SpaceTeam/STS1_PCB_LIBRARIES/3d/STS_Inductor_SMD/vishay_ihlp4040.step

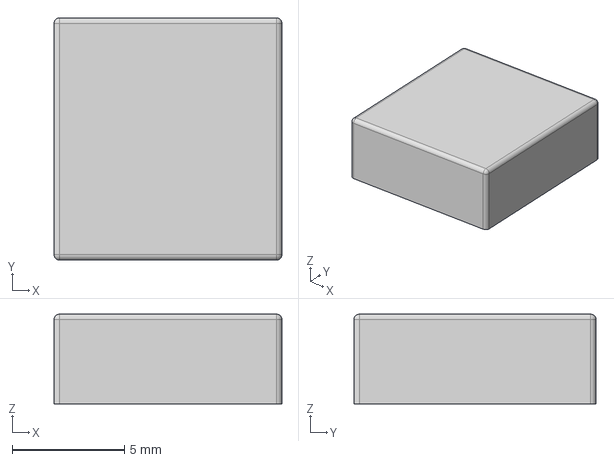
[picture p1: CAD file, 2024-08-04]
3d/STS_Inductor_SMD/vishay_ihlp4040.step
10.2 x 10.8 x 4.00 mm
