SpaceTeam/STS1_PCB_LIBRARIES/3d/STS_Misc/CD4002BNSR.step

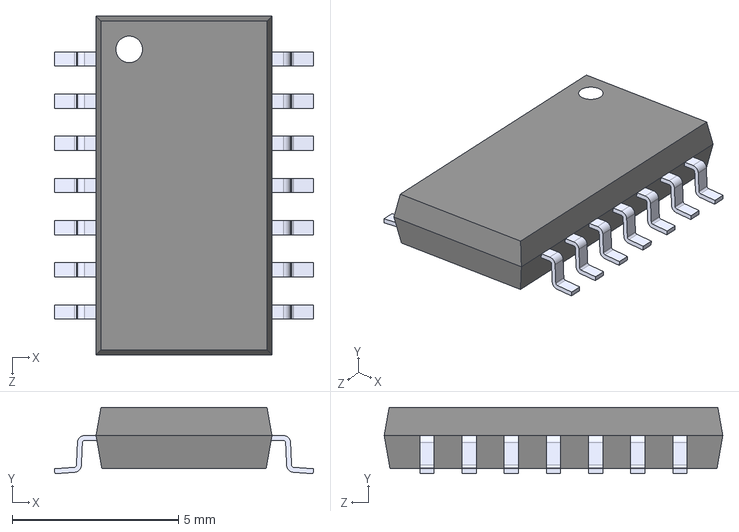
[picture p2: CAD file, 2024-08-04]
3d/STS_Misc/CD4002BNSR.step
7.80 x 2.00 x 10.2 mm
