SpaceTeam/STS1_PCB_LIBRARIES/3d/STS_Package_DFN_QFN/Maxim_22Pin_FC2QFN.step

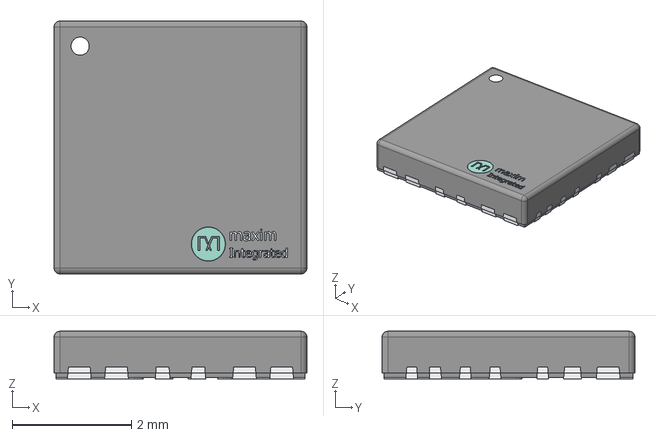
[picture p3: CAD file, 2022-03-08]
3d/STS_Package_DFN_QFN/Maxim_22Pin_FC2QFN.step
4.25 x 4.25 x 0.801 mm
