SpaceTeam/STS1_PCB_LIBRARIES/3d/STS_Package_QSOP/MAX_QSOP24.step

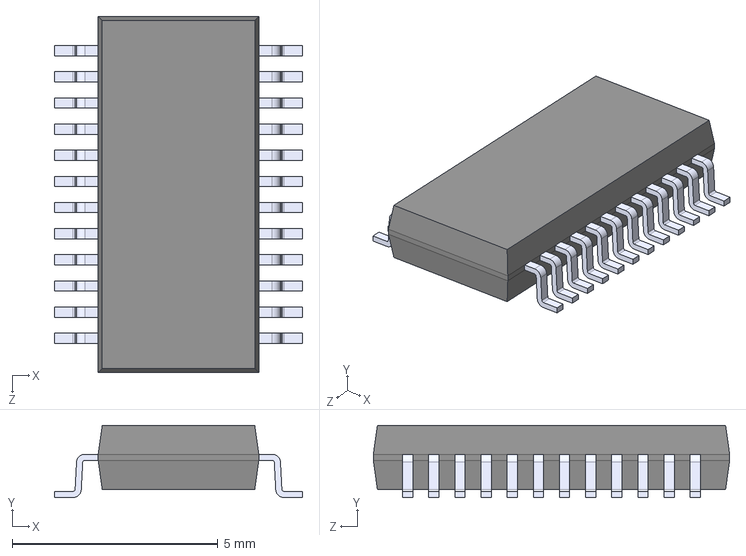
[picture p4: CAD file, 2024-08-04]
3d/STS_Package_QSOP/MAX_QSOP24.step
6.02 x 1.75 x 8.65 mm
