SpaceTeam/STS1_PCB_LIBRARIES/3d/STS_Package_SO/POWERPAK_SO8.STEP

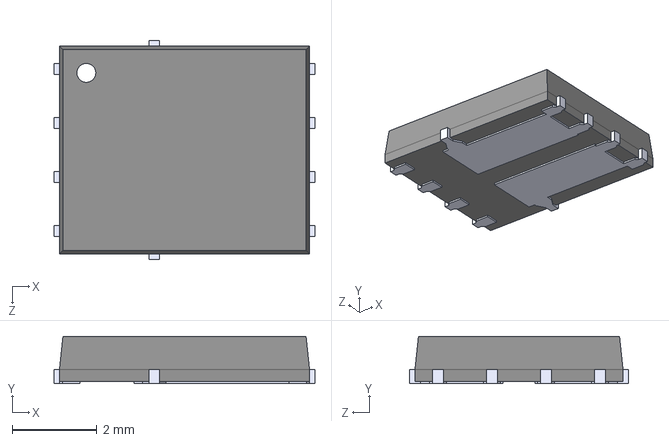
[picture p5: CAD file, 2024-08-04]
3d/STS_Package_SO/POWERPAK_SO8.STEP
6.15 x 1.12 x 5.16 mm
