SpaceTeam/STS1_PCB_LIBRARIES/3d/STS_Package_VSON/TI_VSON8.step

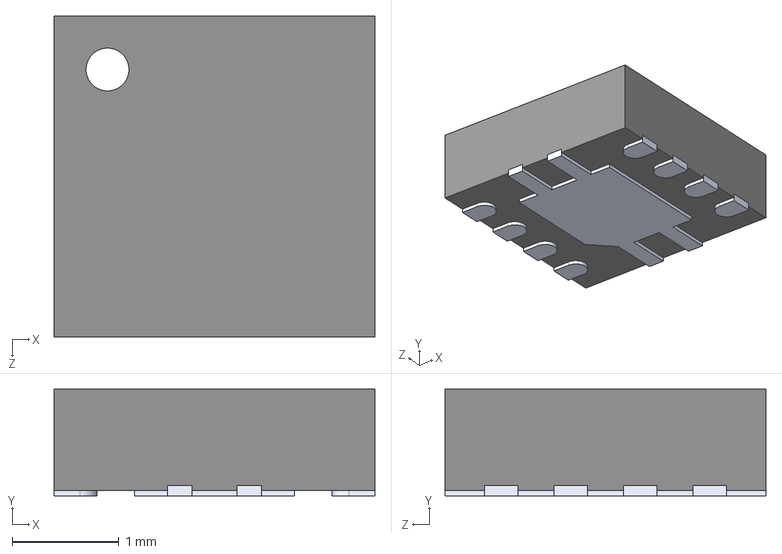
[picture p6: CAD file, 2024-08-04]
3d/STS_Package_VSON/TI_VSON8.step
3.00 x 1.00 x 3.00 mm
