SpaceTeam/STS1_PCB_LIBRARIES/3d/STS_RF/Mini-Circuits-SM1L.stp

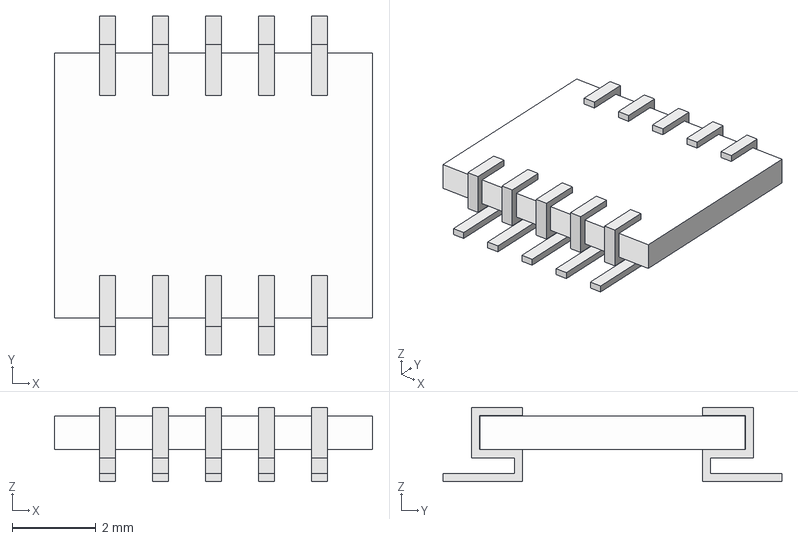
[picture p7: CAD file, 2026-11-08]
3d/STS_RF/Mini-Circuits-SM1L.stp
7.62 x 8.12 x 1.78 mm
Body_Extrude
Pin_Clone9
Pin_Clone5
Pin_Clone6
Pin_Clone7
Pin_Clone8
Pin_Extrude
Pin_Clone1
Pin_Clone2
Pin_Clone3
Pin_Clone4
