SpaceTeam/STS1_PCB_LIBRARIES/3d/TE_Connector_SMB/c-consmb001-g-a-3d.stp

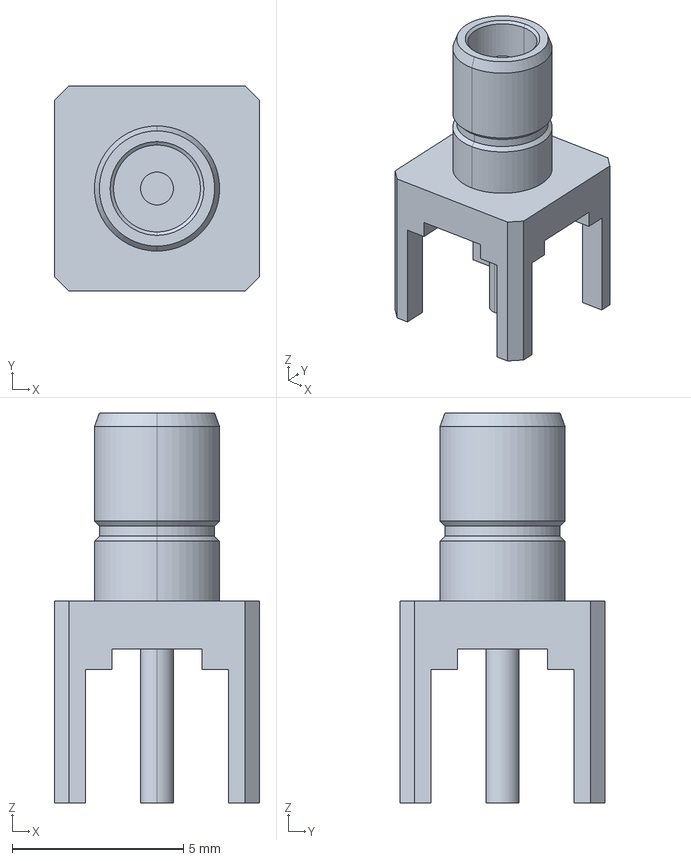
[picture p8: CAD file, 2026-11-08]
3d/TE_Connector_SMB/c-consmb001-g-a-3d.stp
6.00 x 6.00 x 11.4 mm
