SpaceTeam/STS1_PCB_LIBRARIES/3d/STS_Connector/ZF5S-08-01-T-WT.step

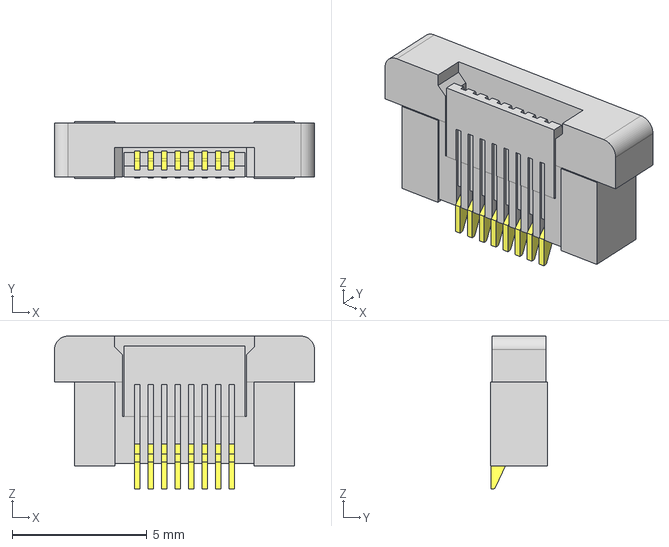
[picture p9: CAD file, 2026-11-08]
3d/STS_Connector/ZF5S-08-01-T-WT.step
9.65 x 2.10 x 5.67 mm
C-297-08-01_pins
ZF5S-08-01-WT_socket
