SpaceTeam/STS1_PCB_LIBRARIES/3d/STS_Inductor_SMD/WE-PD_1260.stp

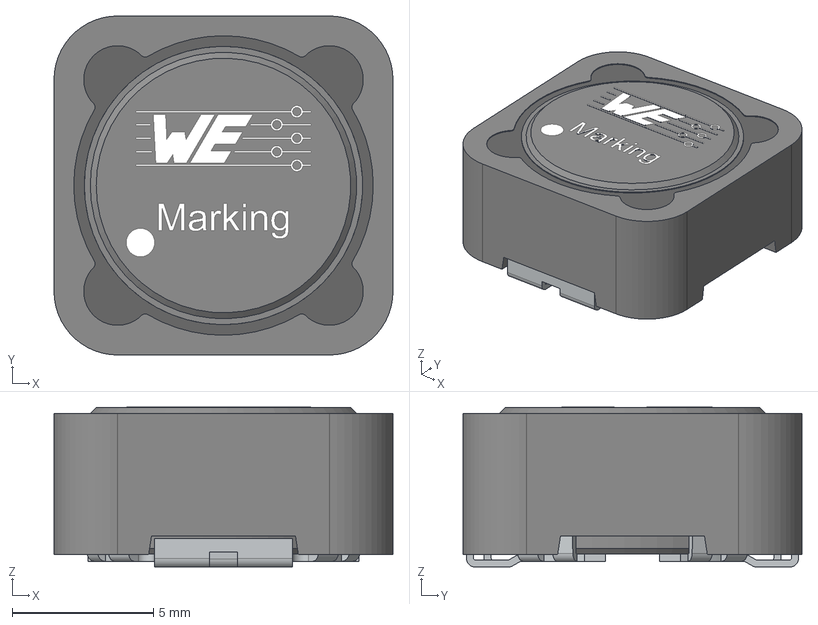
[picture p10: CAD file, 2023-01-22]
3d/STS_Inductor_SMD/WE-PD_1260.stp
12.0 x 12.0 x 5.66 mm
Core
ShieldRing
Glue
Leadframe
