SpaceTeam/STS1_PCB_LIBRARIES/3d/STS_Connector/T1M-08-F-SV-L.stp

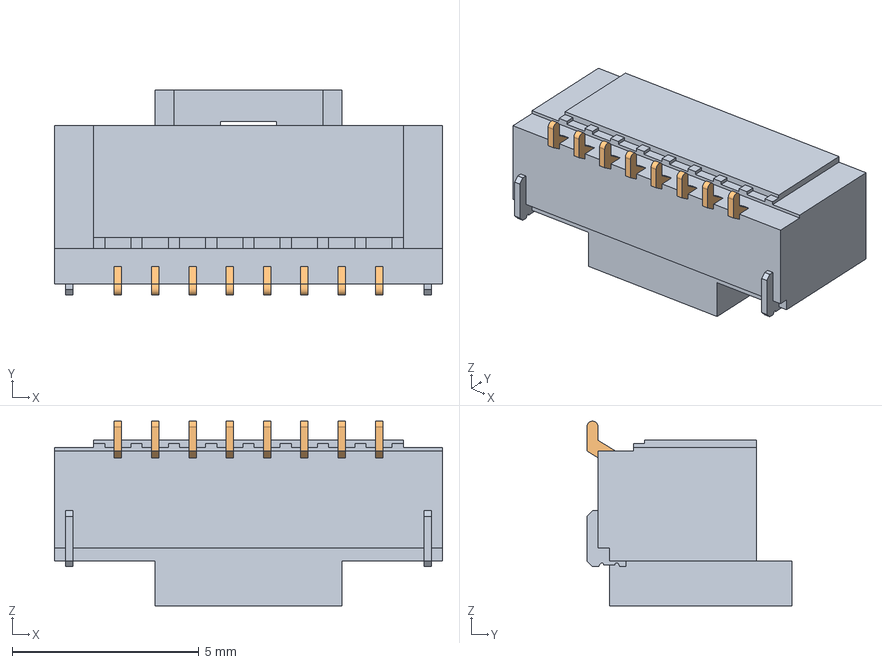
[picture p11: CAD file, 2026-11-08]
3d/STS_Connector/T1M-08-F-SV-L.stp
10.4 x 5.50 x 4.95 mm
T1T1M-08-T-SV-L
P2T1M-08-F-SV-L
P22T1M-08-F-SV-L
