SpaceTeam/STS1_PCB_LIBRARIES/3d/STS_Connector/STS1_EPS_DT_FIX_2.step

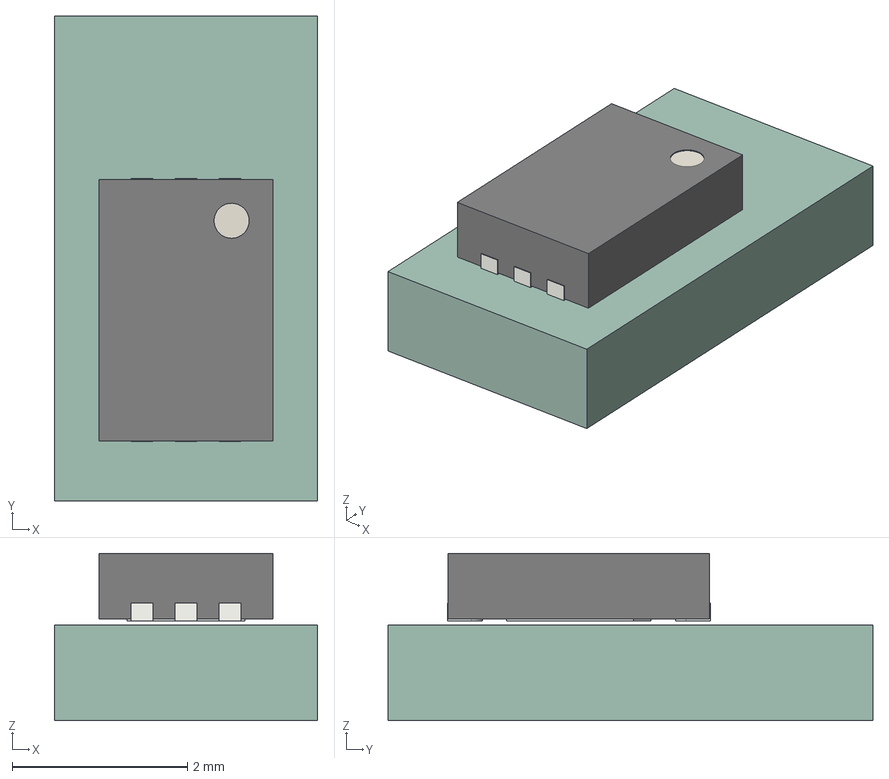
[picture p12: CAD file, 2026-11-08]
3d/STS_Connector/STS1_EPS_DT_FIX_2.step
3.00 x 5.53 x 1.91 mm
DFN_6_1EP_3x2mm_Pitch05mm
STS1_EPS_DT_FIX_2_PCB
