SpaceTeam/STS1_PCB_LIBRARIES/3d/STS_Connector/ZF5S-15-01-T-WT-K-TR.step

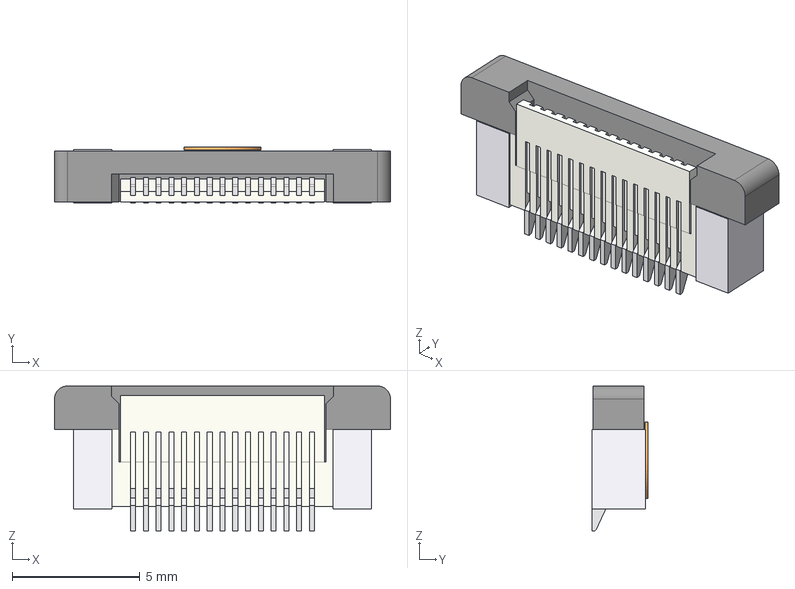
[picture p13: CAD file, 2025-03-16]
3d/STS_Connector/ZF5S-15-01-T-WT-K-TR.step
13.2 x 2.21 x 5.67 mm
ZF5S-15-01-WT_socket
C-297-15-01_pins
K-DOT-.118-.219-.005_polyamide_pick
