SpaceTeam/STS1_PCB_LIBRARIES/3d/STS_Connector/ESQT-125-02-M-D-560.stp

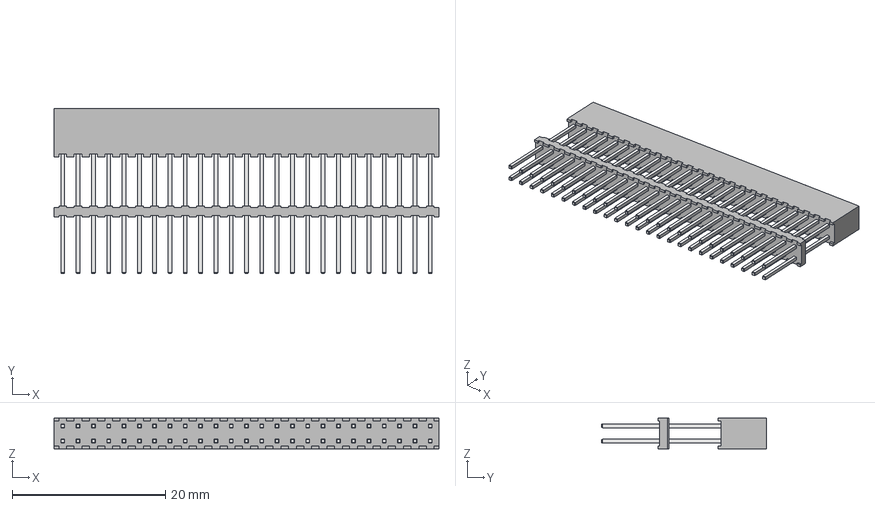
[picture p14: CAD file, 2024-08-04]
3d/STS_Connector/ESQT-125-02-M-D-560.stp
50.3 x 21.6 x 4.00 mm
ESQT-125-02-M-D-560_BS
ESQT-125-02-M-D-5602_P
ESQT-125-02-M-D-560_P
ESQT-125-02-M-D-560_S
