SpaceTeam/STS1_PCB_LIBRARIES/3d/STS_Connector/SQW-125-01-L-D-VS.stp

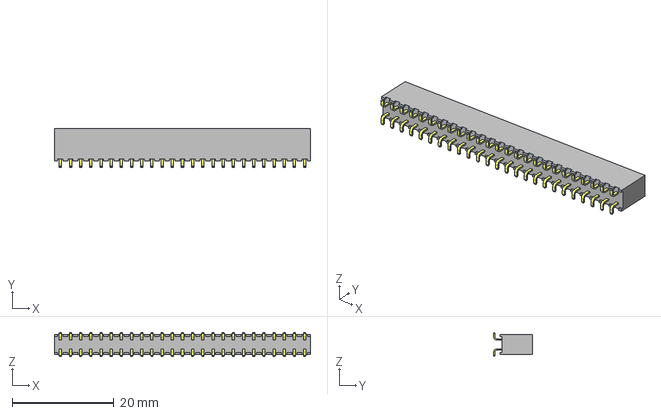
[picture p15: CAD file, 2024-08-04]
3d/STS_Connector/SQW-125-01-L-D-VS.stp
50.3 x 7.62 x 4.75 mm
P1SQW-125-01-L-D-VS
S1SQW-125-01-L-D-VS
