SpaceTeam/STS1_PCB_LIBRARIES/3d/STS_Connector/ETMM-125-02-F-D-SM-TR.stp

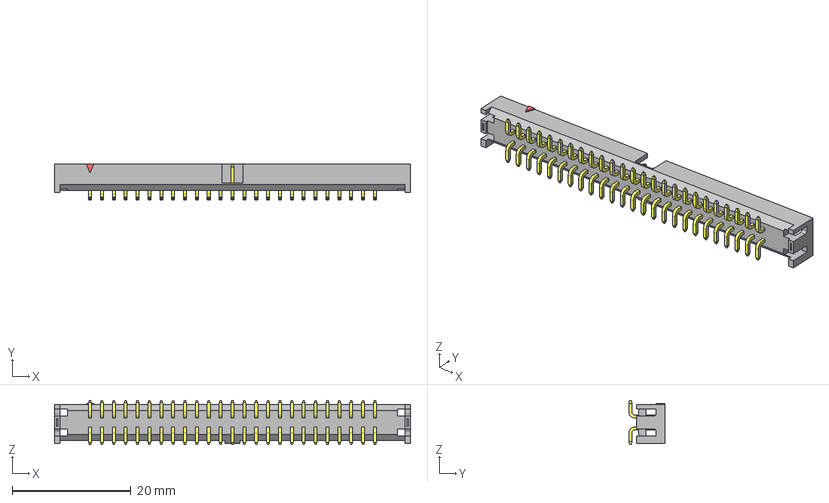
[picture p16: CAD file, 2024-08-04]
3d/STS_Connector/ETMM-125-02-F-D-SM-TR.stp
59.9 x 6.10 x 7.49 mm
ETMM-125-02-F-D-SM-TR_f
ETMM-125-02-F-D-SM-TR_k
ETMM-125-02-F-D-SM-TR_p
ETMM-125-02-F-D-SM-TR_t
