SpaceTeam/STS1_PCB_LIBRARIES/3d/STS_Connector/SSM-125-L-DV.stp

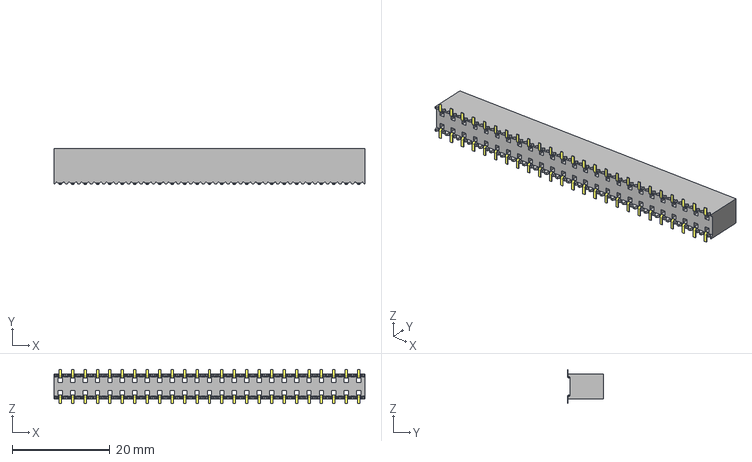
[picture p17: CAD file, 2024-08-04]
3d/STS_Connector/SSM-125-L-DV.stp
63.5 x 7.42 x 7.04 mm
C-137-0125
SSM-125-L-DV_body
