SpaceTeam/STS1_PCB_LIBRARIES/3d/STS_Connector/ESQT-111-02-F-D-640.stp

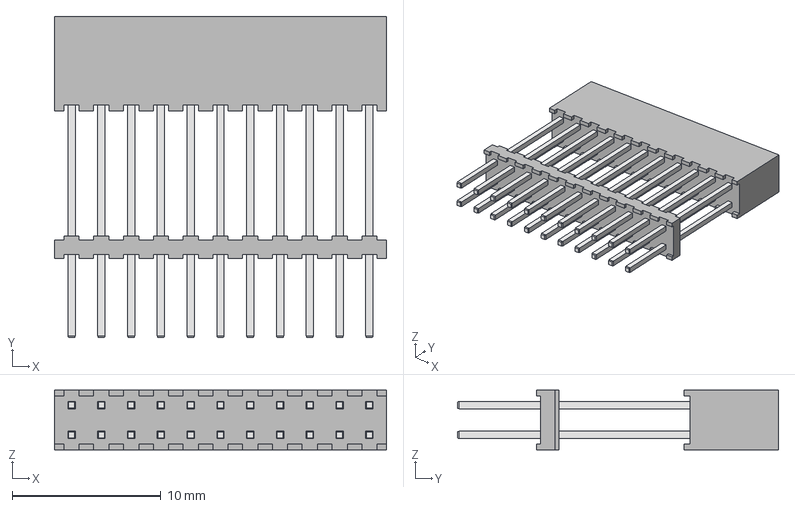
[picture p18: CAD file, 2024-08-04]
3d/STS_Connector/ESQT-111-02-F-D-640.stp
22.3 x 21.6 x 4.00 mm
ESQT-111-02-F-D-640_BS
ESQT-111-02-F-D-6402_P
ESQT-111-02-F-D-640_P
ESQT-111-02-F-D-640_S
