SpaceTeam/STS1_PCB_LIBRARIES/3d/STS_Connector/TMM-125-01-T-D-SM.stp

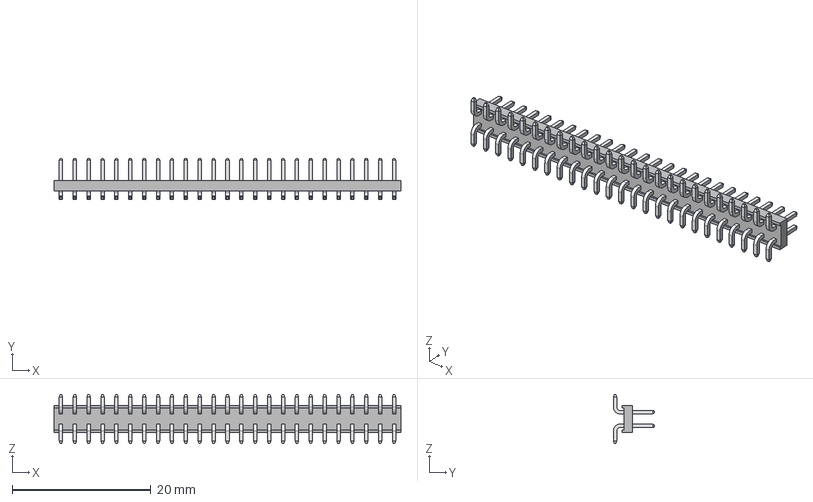
[picture p19: CAD file, 2024-08-04]
3d/STS_Connector/TMM-125-01-T-D-SM.stp
50.0 x 5.97 x 7.06 mm
TMM-125-01-T-D-SM_sm_pins2
TMM-125-01-T-D-SM_pins1
TMM-125-01-T-D-SM_body
