SpaceTeam/STS1_PCB_LIBRARIES/3d/STS_Connector/EHT-125-01-S-D-SM-SR.stp

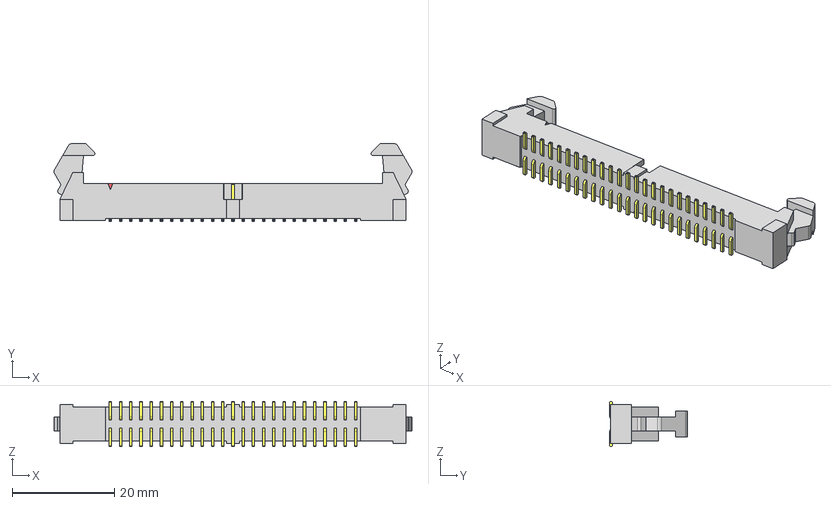
[picture p20: CAD file, 2024-08-04]
3d/STS_Connector/EHT-125-01-S-D-SM-SR.stp
70.0 x 15.2 x 8.89 mm
C-95-01-25-D-SM
EHT-First_Position_Indicator
EHT-125-01-D-SR_header
