SpaceTeam/STS1_PCB_LIBRARIES/3d/STS_Connector/ESQT-110-02-GF-D-800.stp

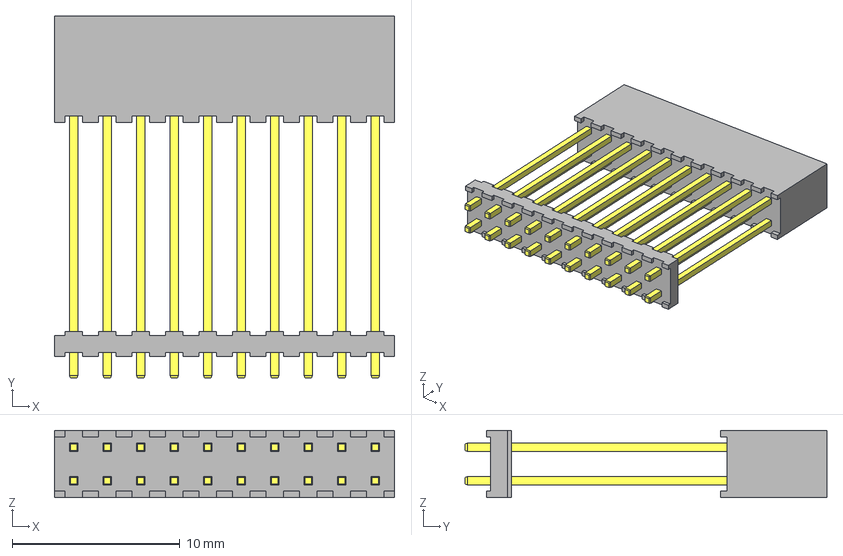
[picture p22: CAD file, 2024-08-04]
3d/STS_Connector/ESQT-110-02-GF-D-800.stp
20.3 x 21.6 x 4.00 mm
ESQT-110-02-GF-D-800_BS
ESQT-110-02-GF-D-800_P
ESQT-110-02-GF-D-800_S
