SpaceTeam/STS1_PCB_LIBRARIES/3d/STS_Connector/SQT-111-02-L-D.stp

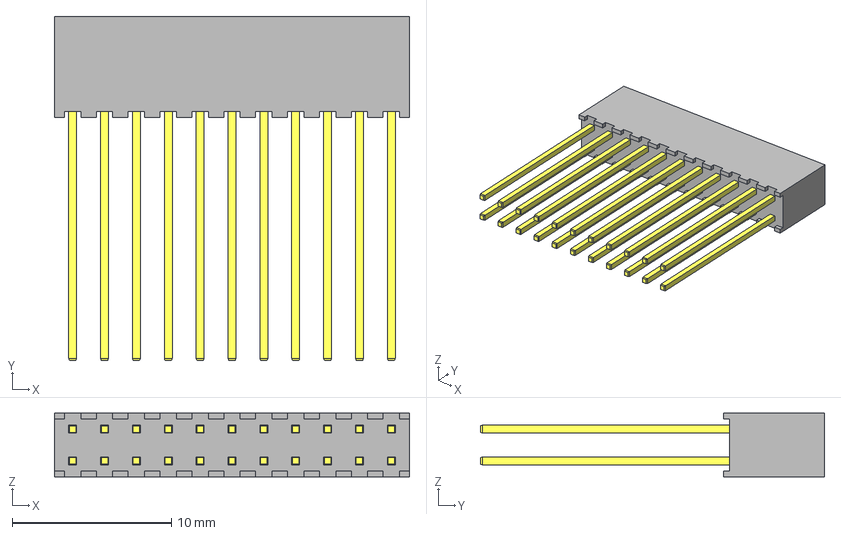
[picture p23: CAD file, 2024-08-04]
3d/STS_Connector/SQT-111-02-L-D.stp
22.3 x 21.6 x 4.00 mm
P1SQT-111-02-L-D
S1SQT-111-02-L-D
