SpaceTeam/STS1_PCB_LIBRARIES/3d/STS_Connector/ZF5S-08-03-T-WT.stp

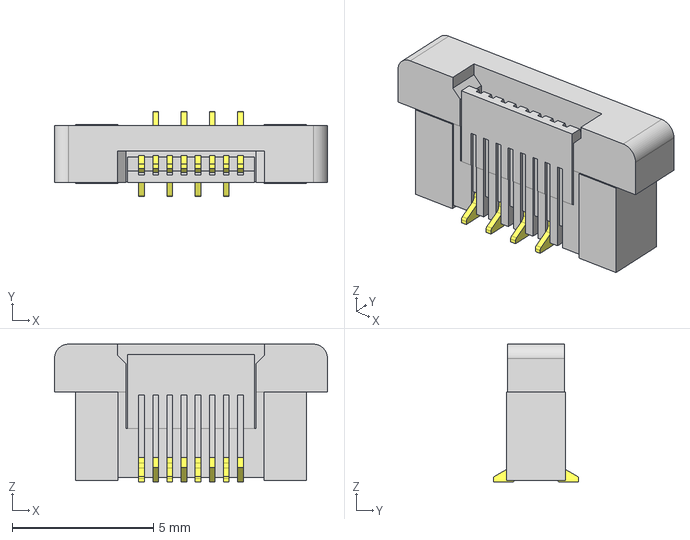
[picture p24: CAD file, 2024-08-04]
3d/STS_Connector/ZF5S-08-03-T-WT.stp
9.65 x 3.02 x 4.87 mm
C-297-08-03_pins
ZF5S-08-03-WT_socket
