SpaceTeam/STS1_PCB_LIBRARIES/3d/STS_Connector/ZF5S-10-01-T-WT.stp

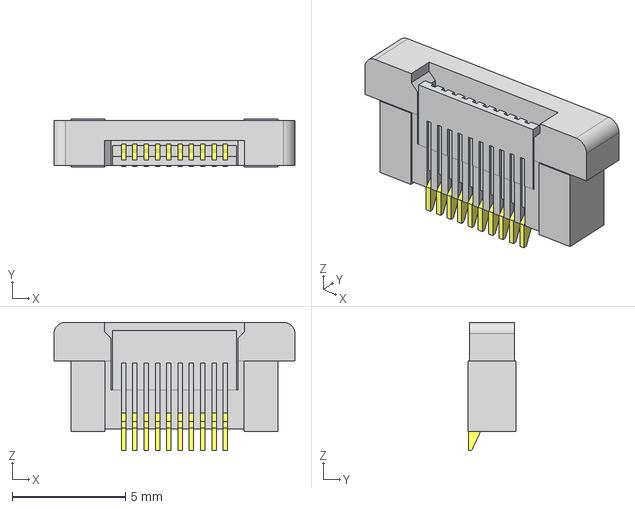
[picture p25: CAD file, 2024-08-04]
3d/STS_Connector/ZF5S-10-01-T-WT.stp
10.7 x 2.10 x 5.67 mm
C-297-10-01_pins
ZF5S-10-01-WT_socket
