SpaceTeam/STS1_PCB_LIBRARIES/3d/STS_Connector/ESQT-125-02-M-D-640.stp

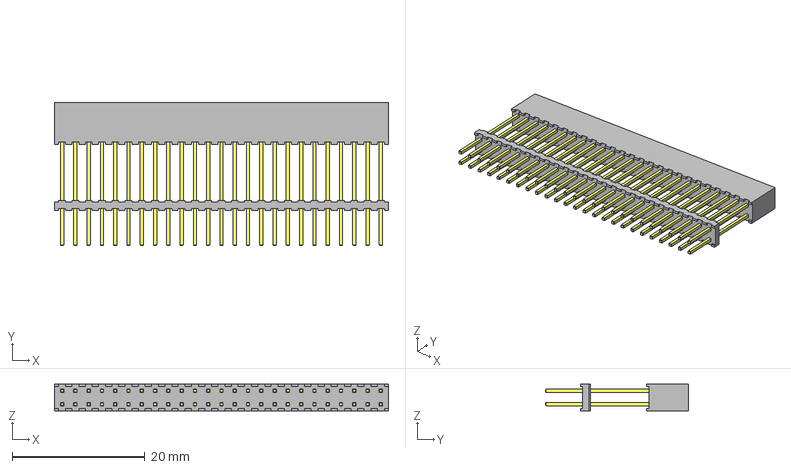
[picture p26: CAD file, 2024-08-04]
3d/STS_Connector/ESQT-125-02-M-D-640.stp
50.3 x 21.6 x 4.00 mm
ESQT-125-02-M-D-640_BS
ESQT-125-02-M-D-640_P
ESQT-125-02-M-D-640_S
