SpaceTeam/STS1_PCB_LIBRARIES/3d/STS_Connector/ZF5S-16-03-T-WT.step

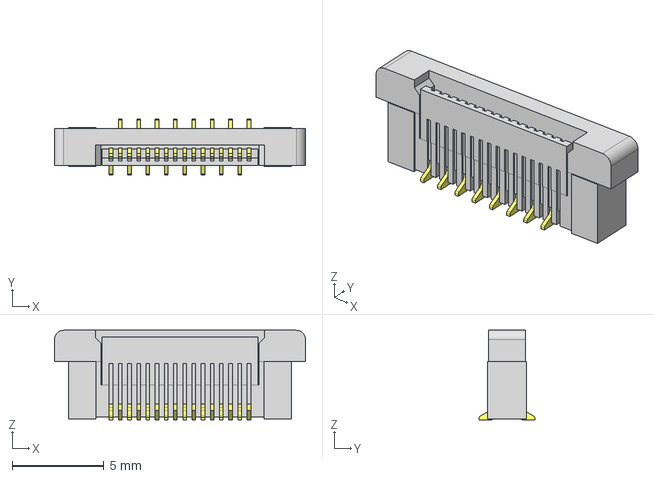
[picture p27: CAD file, 2024-08-04]
3d/STS_Connector/ZF5S-16-03-T-WT.step
13.7 x 3.02 x 4.87 mm
ZF5S-16-03-WT_socket
C-297-16-03_pins
