SpaceTeam/STS1_PCB_LIBRARIES/3d/STS_Connector/FTSH-105-01-X-DH-A.step

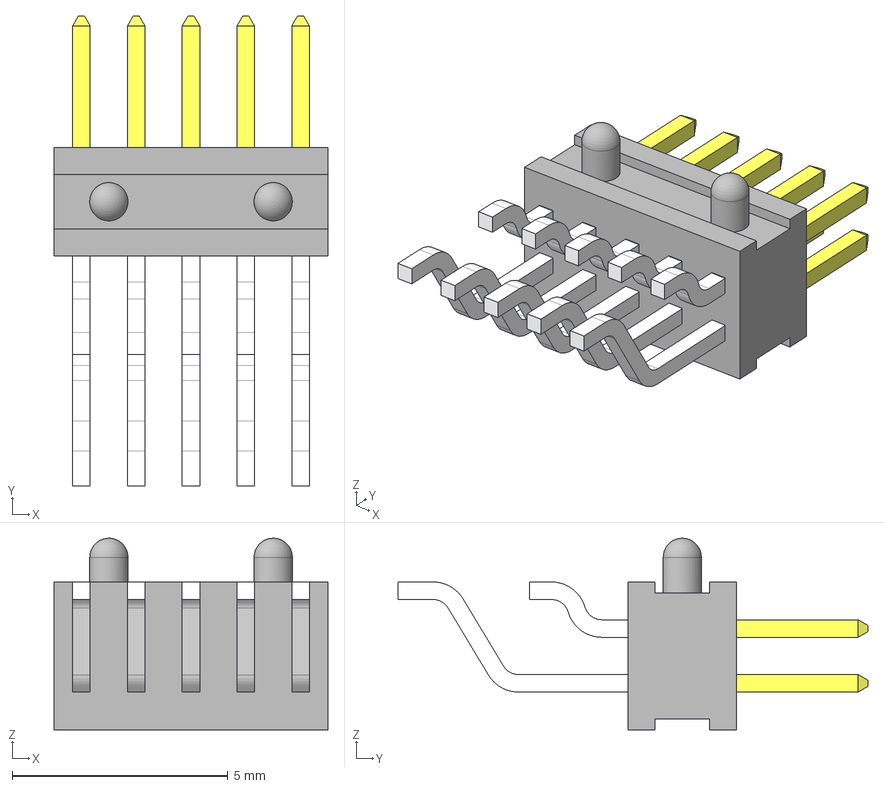
[picture p28: CAD file, 2023-01-22]
3d/STS_Connector/FTSH-105-01-X-DH-A.step
6.35 x 10.9 x 4.45 mm
FTSH-105-01-L-DH-TR_pins2
FTSH-105-01-L-DH-TR_pins1
FTSH-105-01-L-DH-A-TR_body
