SpaceTeam/STS1_PCB_LIBRARIES/(list of files, cad)

Other CAD files:
3d/STS_Package_SO/POWERPAK_SO8_single.STEP
3d/STS_Connector/ESQT-111-02-F-D-800.stp
3d/STS_Connector/ESQT-111-02-M-D-560.stp
3d/STS_Connector/1725672.stp
3d/STS_Connector/2078430004.stp
3d/STS_Connector/282834-4.step
3d/STS_Connector/282834-6.step
3d/STS_Connector/282834-7.step
3d/STS_Connector/436500415.stp
3d/STS_Connector/501461-0491.stp
3d/STS_Connector/M80-8280442P.stp
3d/STS_Connector/M80-8510845.stp
3d/STS_Connector/M80-8661205.stp
3d/STS_Connector/M80-8760205.stp
3d/STS_Connector/ZF5S-08-01-T-WT.stp
3d/STS_Connector/m80-8280842.stp
3d/STS_Connector/m80-8510442.stp
3d/STS_Connector/m80-8511022.stp
3d/STS_RF/Mini-Circuits-SM1L.FCStd
