SpaceTeam/STS1_PCB_LIBRARIES/(commit log)

2021-10-27 Update libraries with the COBC libs
    [F27 F30 package 2018(1).dxf, F27 F30 package 2018(1).pcb, F27 F30 package 2018(2).dxf, F27 F30 package 2018(2).pcb, F27 F30 package 2018(3).dxf, F27 F30 package 2018(3).pcb, F27 F30 package 2018.dxf, F27 F30 package 2018.pcb]
2021-11-29 Add UV sensors for on boarding sensor HAT project
    - Added GUVx-C3xSM
    - Added LTR-390
    - Added VEML6070
    - Added VEML6075
    - Added SI114x
2022-03-08 Add new inductors and dc/dc converter models
    [595D_A-case.stp, 595D_B-case.stp, 595D_C-case.stp, 595D_D-case.stp, 595D_G-case.stp, 595D_M-case.stp, 595D_R-case-corrected.stp, 595D_R-case.stp]
2022-04-19 Add new DCDC Controller and inductors
    [MAX16990ATCE_V_.step]
2022-04-27 starting cleanup
    [595D_A-case.stp, 595D_B-case.stp, 595D_C-case.stp, 595D_D-case.stp, 595D_G-case.stp, 595D_M-case.stp, 595D_R-case-corrected.stp, 595D_R-case.stp]
2022-04-27 add maxim 22pin fc2qfn 3d file
    [Maxim_22Pin_FC2QFN.step]
2022-05-08 Added new parts for new dcdc converter
    [WE-PD-1260P.stp]
2022-05-15 Added symbols, footprints and 3d models that correspond to the eps.
    [M80-8661205.stp, MAX_QSOP24.step, POWERPAK_SO8.STEP, POWERPAK_SO8_single.STEP, TI_VSON8.step]
2022-06-08 Added some ICs.
    [436500415.stp, M80-8510845.stp]
2022-06-29 Added some EPS related connectors.
2022-07-04 Added some 3d files.
    [M80-8760205.stp, m80-8510442.stp, m80-8511022.stp]
2022-07-06 Modified AD_LQFN-16.kicad_mod so areas connect to it.
2022-07-12 Modified QSOP24 footprint.
2022-07-15 Add special Footprints for ICs used on COBC
2022-07-17 Modified some footprints, as they caused DRC clearance errors.
2022-07-20 Solder mask was incorrectly set for AD_LQFN-16.kicad_mod. Fixed that.
2022-07-29 Added the footprints and 3D models for the SMD connectors of the panel PCBs.
    [m80-8280442.stp, m80-8280842.stp]
2022-08-15 add STM Nucleo 64 symbol and footprint
2022-08-20 add footprints and symbols
    added TP5000 Breakout footprint and updated the symbol
    added a symbol to link to external resources without pasting the
    URL into a textbox
2022-09-23 add Morpho 64 wihtout Arduino pins
2022-10-17 add Morpho 64 without mountingholes
2023-01-06 Add sts connector and coordinate system
2023-01-22 Add some footprints and 3D models
    [FTSH-105-01-X-DH-A.step, WE-PD_1260.stp]
2023-06-13 - Added 3d file for IHLP4040 SMD inductor. - Assigned 3d file to ad_lqfn-16
    [vishay_ihlp4040.step]
2023-08-28 Added a few EPS related connectors
    [EHT-125-01-S-D-SM-SR.stp, ESQT-125-02-M-D-640.stp, ETMM-125-02-F-D-SM-TR.stp, SQT-125-02-L-D.stp, SQW-125-01-L-D-VS.stp, SSM-125-L-DV.stp, TMM-125-01-T-D-SM.stp, ZF5S-08-01-T-WT.stp]
2023-08-29 Added some eps related symbols/footprints.
2023-08-29 Repaired pin numbering of SAMTEC_ZF5S-08-03-T-WT.kicad_mod.
2023-08-29 Connected 3d model to SAMTEC_ZF5S-08-03-T-WT.kicad_mod.
2023-09-12 Added EPS related footprint.
2023-09-17 Added EPS related stp file for a connector.
    [ESQT-110-02-GF-D-800.stp]
2023-09-17 Added some EPS related parts.
    [2078430004.stp]
2023-10-14 added some symbols, footprints and 3d models
    [501461-0491.stp, 54548-2271.stp, M80-8280442P.stp, SMM4F5.0A-TR.stp, XAL6060-103MEC.stp, ZF5S-08-01-T-WT.step]
2023-10-26 Added EPS specific Connectors.
    [ESQT-111-02-F-D-640.stp, SQT-111-02-L-D.stp]
2023-10-29 Added EPS specific connectors ...again.
    [ESQT-111-02-M-D-560.stp, ESQT-125-02-M-D-560.stp]
2024-04-14 Added some footprints and 3d files.
    [CD4002BNSR.step]
2024-05-09 feat: add TE SMB connector 3D files
    [c-consmb001-g-a-3d.stp, c-consmb006-g-a-3d.stp]
2024-05-09 feat: add minicircuits sm1l 3d model
    [Mini-Circuits-SM1L.FCStd, Mini-Circuits-SM1L.stp]
2024-06-08 Updated a footrpint for KiCad 8.0.
2024-07-18 Added new FFC connector for the UCI connector (EPS -> sidepanel).
    [ZF5S-16-03-T-WT.step]
2024-07-22 Added symbol and footprint for a TVS diode.
2024-08-06 Added inter eps connector.
2024-08-14 Updated some footprints.
2024-09-02 Modified some silkscreen text.
2024-09-12 Modified the paths to 3D models of some footprints, so that they are more portable.
    # Conflicts:
    # footprint/STS_Package_SO.pretty/POWERPAK_SO8_single.kicad_mod
2025-03-16 Added a few screw connectors.
    [1725672.stp, 282834-6.step, 282834-7.step, ZF5S-15-01-T-WT-K-TR.step]
2025-03-24 Added a few connectors.
    [282834-4.step]
2025-04-02 Fixed symbol for the deployment timer and added footprint for the DT_FIX PCB.
2025-04-06 Updated the dt_fix footprint.
    [STS1_EPS_DT_FIX.step]
2025-04-07 Added alternative dt_fix
    [STS1_EPS_DT_FIX_2.step]
2025-04-08 Updated dt_Fix footprint with host-independent path to 3d model.
2026-07-21 Added 3D models for SAMTEC Micro Mate connectors.
    [T1M-08-F-SV-L.stp, T1M-16-F-SV-L.stp]
