SpaceTeam/STS1_PCB_LIBRARIES/(notices)

Notices in the files:
3d/STS_Connector/ZF5S-15-01-T-WT-K-TR.step:
author */ ('License CC BY-ND 4.0'),
